granizocieza-cmyk/cartel-led-no-pasar-teletrabajo/(commit log)

2026-11-08 Esqueleto del repositorio: licencia MIT y .gitignore (secretos fuera de git)
2026-11-08 Normaliza finales de línea con .gitattributes
2026-11-08 Firmware ESP32: servidor HTTP, mDNS, fuente 3x5, animaciones y limitador de consumo
2026-11-08 Agente de Windows: detección WASAPI del micro, antirrebote, latido y cliente WinHTTP
2026-11-08 Simulación web interactiva (GitHub Pages), pruebas de ciclo y comparación firmware/web, GIF de demostración
2026-11-08 Proyecto Wokwi (diagram.json, wokwi.toml) y orden de matriz automático en simulación
2026-11-08 README en español: arquitectura, materiales, montaje, consumo, nivel lógico, privacidad
2026-11-08 Corrige saltos de línea del diagrama Mermaid
2026-11-09 Maqueta 3D: maniquí articulado, habitación, cartel de LEDs y pantalla de videollamada
    Geometría propia con three.js (sin modelos ni texturas externas). La interfaz
    de llamada es genérica, sin marcas.
2026-11-09 Escena 3D con guion, telemetría y cámaras; la 2D pasa a ligero.html como respaldo
    Reutiliza nucleo.js (Agente y Cartel) para estados, texto y animaciones.
    Si WebGL o el CDN fallan, redirige a la versión ligera.
2026-11-09 README con la maqueta 3D, créditos y script que genera las capturas
2026-11-09 Arregla el rótulo del deslizador de brillo en el panel
2026-11-09 Personas más elaboradas: ropa, pelo, calzado y esqueleto de articulaciones propio
    Geometría torneada propia (sin modelos glTF): cabeza con cuello, torso, brazos con
    codo y mano, piernas con rodilla y zapatos. Tres estilos distintos. Andar con
    balanceo de brazos, rodillas y tobillos; teclear y gesticular al hablar; giros con
    la cabeza por delante del cuerpo.
2026-11-09 Bocadillo flotante de llamada anclado a la persona y estilos de personas en la escena
    Capa HTML sincronizada con la máquina de estados (entrante, en llamada con contador
    y micro activo, finalizada). Se aparta del cartel y se ajusta a la zona libre.
2026-11-09 README sin la animación 3D: enlaces destacados a la simulación 3D y a la 2D ligera
    Se borran escena3d.gif y escena3d.png. El script de capturas pasa a generar solo
    imágenes de revisión (carpeta ignorada por git).
2026-11-09 README: el GIF del cartel LED baja a la sección «Cómo funciona»; arriba solo los enlaces
